b-47/punch-point/README.md

# Punch Point

A low-cost, portable braille embosser.

- [Test rig viewer](https://b-47.github.io/punch-point/concepts/test-rig/viewer/)

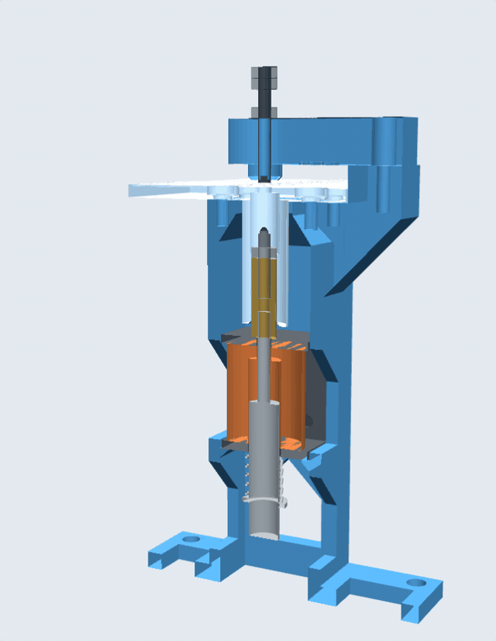
[picture p1: concepts/test-rig/media/strike.gif]
Test rig: the solenoid drives the stylus up through the paper into the die
  

- [Six-solenoid head viewer](https://b-47.github.io/punch-point/concepts/six-solenoid-head/viewer/)

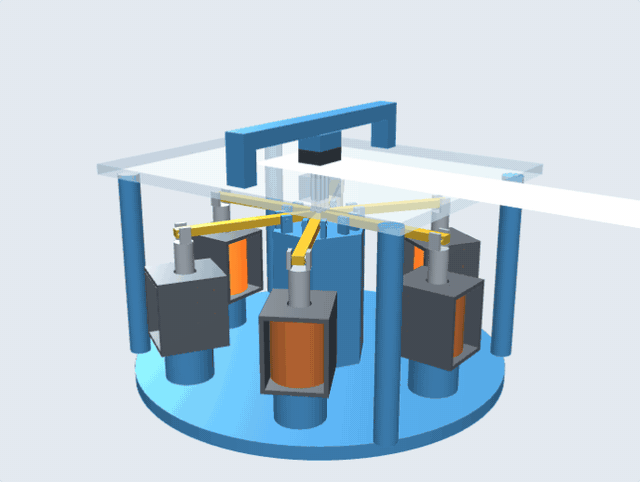
[picture p2: concepts/six-solenoid-head/media/emboss.gif]
Six-solenoid head embossing "punch" one braille cell per strike
  

## License

MIT, see [LICENSE](LICENSE).
