b-47/punch-point/concepts/six_solenoid_head/viewer/index.html

Punch Point · concept sketch, not a tested design

# Six-Solenoid Head

One whole braille cell per strike. Six solenoids stand on a ring and pull six levers. The levers pivot near the middle, so their short inner ends lift six steel pins, set 2.5 mm apart in a 2 × 3 grid, up through the paper into a six-pocket die. Dot-matrix printer heads use the same trick to fit big actuators around a tiny grid of pins.

Lever ratio

3.2 : 1

Pin stroke

3.2 mm

Pin force

≈ 3 × solenoid

Head

≈ 145 mm across

Whole head Pins up close From above Hide table and die

Loading parts…

Word to emboss (letters a–z and spaces)

Emboss Pause

Firing

All of a cell's dots at once One dot after another

p

dots 1 2 3 4

Solenoids on

0

Current now

0 A

Strikes this cell

1

Cells done

0 / 11

Slowed down. Each solenoid draws about 2 A at 12 V while it's on, so firing a whole cell at once needs up to 12 A; one after another never needs more than 2 A but takes a strike per dot.

## What a six-pin head takes

- Six levers and pivots. A solenoid is 22 mm wide and the dots are 2.5 mm apart, so each one reaches its pin through a lever. The 3.2 : 1 ratio turns the 10 mm solenoid stroke into about 3 mm at the pin, at about three times the force, minus pivot friction.
- A six-pocket metal die. Each pin needs its own pocket, lined up within a tenth of a millimetre or so. M3 set screws are 3 mm wide and can't sit 2.5 mm apart, so this is a drilled steel block.
- Power. Up to 12 A when a full cell fires at once, against 2 A for one pin.
- Size and weight. About 145 mm across with six solenoids, all riding on the carriage.
- Parts. The solenoids are cheap (about $3.30 each on the order sheet). The cost is the levers, pivots, pins, die and a bigger supply, plus six channels of the test circuit.

## Speed, and pictures

Rough model for a full page of text (25 lines × 31 cells, about 3 dots a cell). These are estimates, not measurements; the test rig's strike time will firm them up.

Head | Strikes per cell | Page, roughly
One pin | one per dot | ≈ 6 min
Six pins, one after another | one per dot | ≈ 3.5 min
Six pins, all at once | one | ≈ 2 min

Pictures run at one-pin speed whatever the head has: for a tactile graphic the head uses a single pin and moves it anywhere on the page. Six pins only speed up text.
