b-47/punch-point/concepts/six-solenoid-head/cad/iterations/six_head_001_top.png

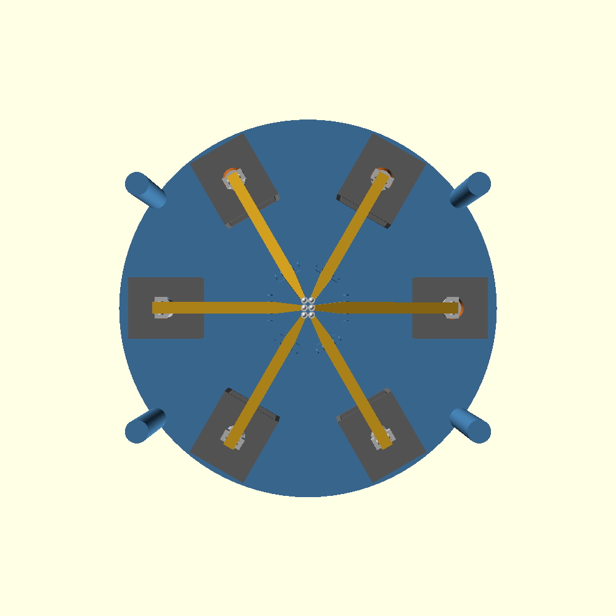
concepts/six-solenoid-head/cad/iterations/six_head_001_top.png
