b-47/punch-point/bom/parts.csv

part | details | unit_cost | qty_one_stylus | qty_six_styli | checked | link
Solenoid | JF-0826B, 12 V, 10 mm stroke | 3.30 | 1 | 6 | 2026-10-16 | https://www.alibaba.com/product-detail/JF-0826B-DC-12V-24V-2A_1600634368825.html
Stylus | M3 x 16 dog-point set screw on an M3 x 18 standoff, with a nut | 1.50 | 1 | 0 | 2026-10-16
Pins and levers | Steel pins and printed levers, one per solenoid | 0.25 | 0 | 6 | 2026-10-16
Die for one stylus | Not designed yet: a die that moves with the stylus, or a fixed grooved bar | 5.00 | 1 | 0 | 2026-10-16
Six-pocket die | A drilled steel block, or the Perkins brailler die if it fits | 10.00 | 0 | 1 | 2026-10-16
Stepper motor | NEMA 17, 42 x 42 x 38 mm: one moves the head, one feeds the paper | 4.72 | 2 | 2 | 2026-10-16 | https://www.omc-stepperonline.com/e-series-nema-17-bipolar-42ncm-59-49oz-in-1-5a-42x42x38mm-4-wires-w-1m-cable-connector-17he15-1504s
Stepper driver | DRV8825 | 2.11 | 2 | 2 | 2026-10-16 | https://www.oyostepper.com/goods-887-5PCSPack-DRV8825-Stepper-Driver-Module-with-Heat-Sink-for-3d-Printer-Reprap.html
Belt | GT2, 6 mm wide, in meters | 1.60 | 0.7 | 0.7 | 2026-10-16
Belt pulley | GT2, 20 teeth | 2.95 | 1 | 1 | 2026-10-16 | https://www.zyltech.com/2gt-gt2-6mm-wide-20t-pulley-5mm-6-35mm-or-8mm-bore/
Idler pulley | GT2, 20 teeth | 3.25 | 1 | 1 | 2026-10-16 | https://www.amazon.com/Double-Idler-Timing-Pulley-Printer/dp/B077MD37XP
Smooth rod | 8 mm across, about 350 mm long | 6.00 | 2 | 2 | 2026-10-16
Linear bearing | LM8UU | 0.67 | 4 | 4 | 2026-10-16
End switch | Finds the head's start position | 1.00 | 1 | 1 | 2026-10-16
Roller shaft | 8 mm across, about 250 mm long | 5.00 | 2 | 2 | 2026-10-16
Rubber ring | O-rings that grip the paper | 0.06 | 8 | 8 | 2026-10-16
Ball bearing | 608 | 0.70 | 4 | 4 | 2026-10-16
Paper sensor | TCRT5000 infrared sensor, finds the paper's edge | 1.20 | 1 | 1 | 2026-10-16
ESP32 board |  | 7.39 | 1 | 1 | 2026-10-16 | https://www.jacobsparts.com/items/DEVBOARD-J
Solenoid driver | MOSFET, diode, 2 resistors and a capacitor, one set per solenoid | 1.50 | 1 | 6 | 2026-10-16
Circuit board and connectors |  | 5.00 | 1 | 1 | 2026-10-16
Wire |  | 3.00 | 1 | 1 | 2026-10-16
Power supply | Sealed 12 V, 5 A wall adapter | 16.00 | 1 | 0 | 2026-10-16
Power supply for six solenoids | Sealed wall adapter; its size depends on how many solenoids fire at once | 28.00 | 0 | 1 | 2026-10-16
PLA filament | Frame, carriage, paper guides and cover, in kg | 12.00 | 0.5 | 0.5 | 2026-10-16
Screws and nuts |  | 5.00 | 1 | 1 | 2026-10-16
