b-47/punch-point/concepts/test-rig/media/v020/3-printed-parts.png

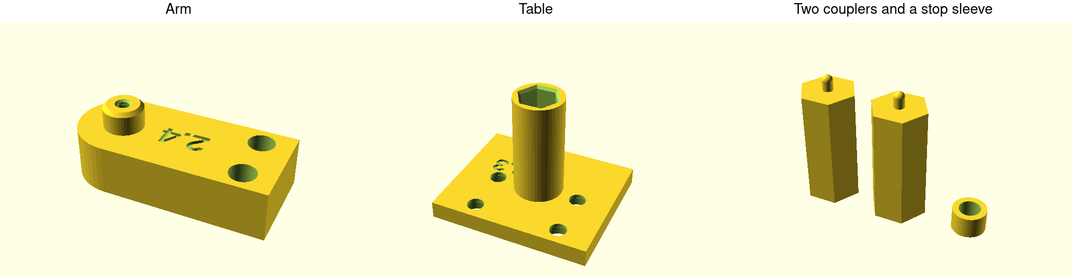
concepts/test-rig/media/v020/3-printed-parts.png
