b-47/punch-point/concepts/test-rig/print/filament_plate_mk4.3mf

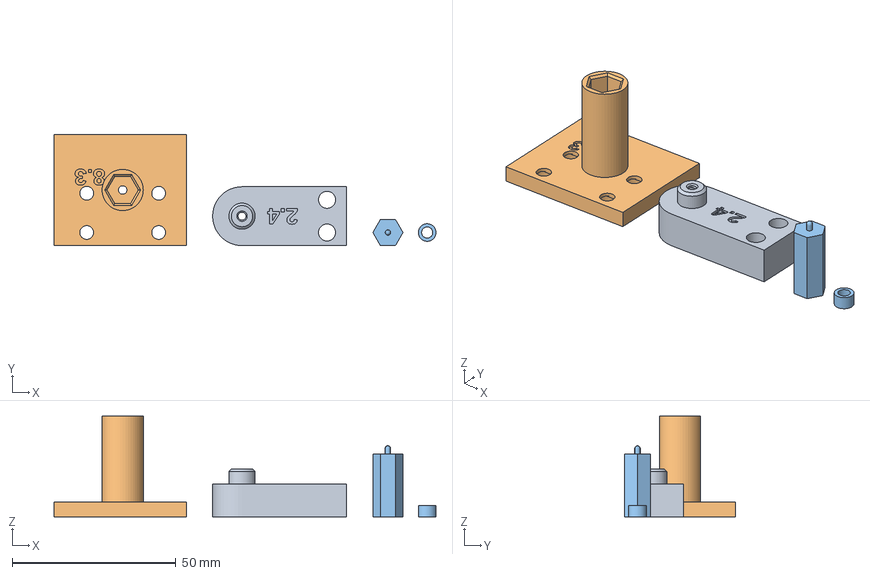
[picture p6: CAD file, 2026-10-30]
concepts/test-rig/print/filament_plate_mk4.3mf
116.8 x 34.0 x 30.8 mm
arm.stl
table_coupler.stl
coupler_parts.stl
