b-47/punch-point/concepts/test-rig/print/coupler_parts.stl

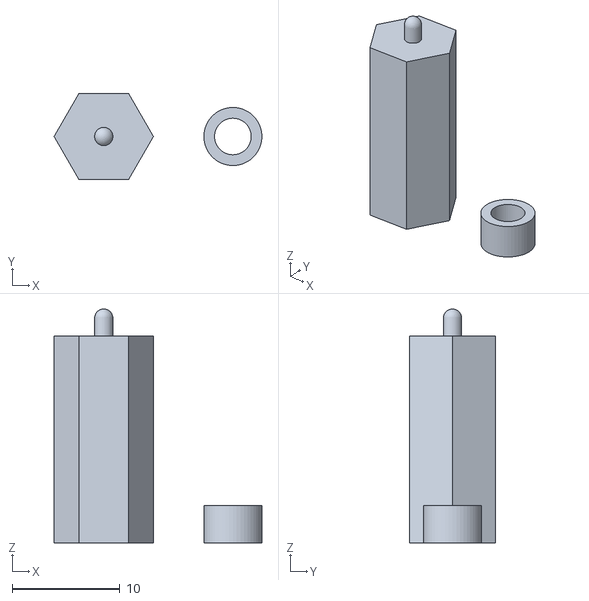
[picture p7: CAD file, 2026-10-30]
concepts/test-rig/print/coupler_parts.stl
19.3 x 8.00 x 21.7
