b-47/punch-point/concepts/test-rig/print/table_coupler.stl

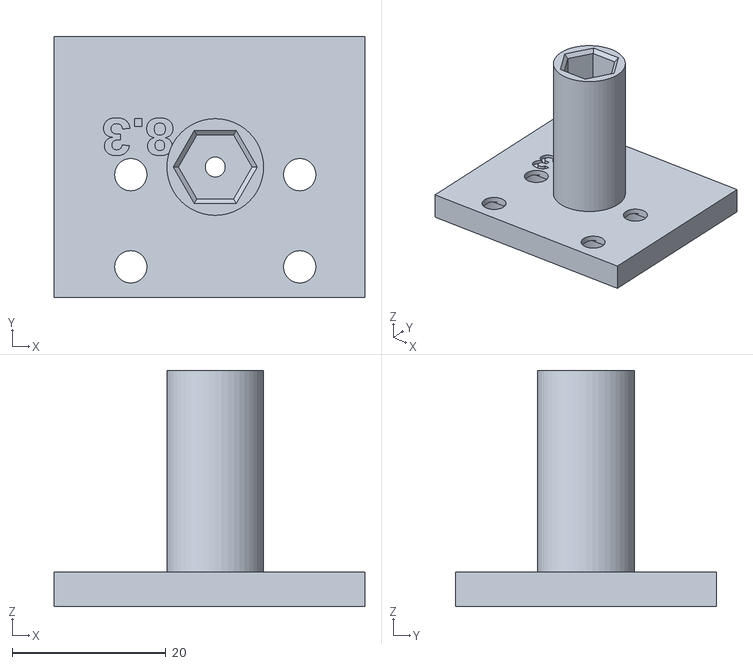
[picture p8: CAD file, 2026-10-30]
concepts/test-rig/print/table_coupler.stl
40.5 x 34.0 x 30.8
