b-47/punch-point/concepts/test-rig/print/arm.stl

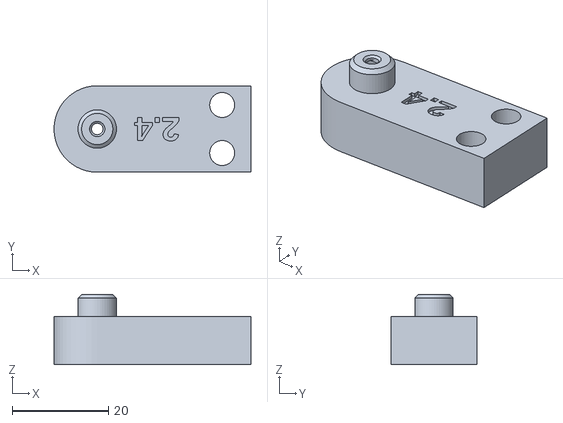
[picture p9: CAD file, 2026-10-30]
concepts/test-rig/print/arm.stl
41.0 x 18.0 x 14.6
