b-47/punch-point/concepts/test-rig/print/rig_plate.3mf

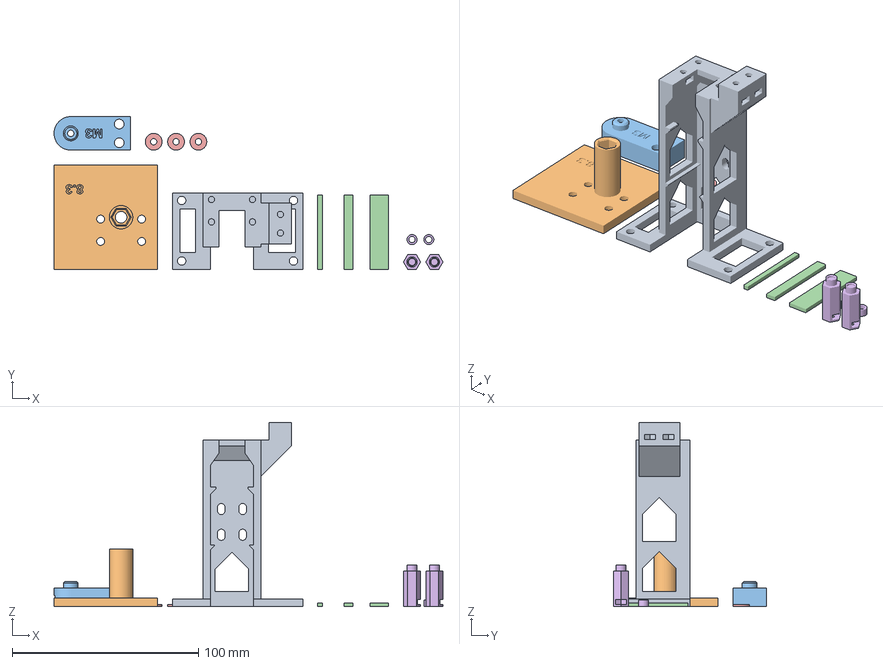
[picture p10: CAD file, 2026-10-23]
concepts/test-rig/print/rig_plate.3mf
208.7 x 82.0 x 98.8 mm
frame.stl
table_coupler.stl
arm_m3.stl
shims.stl
washers.stl
coupler_parts.stl
