b-47/punch-point/concepts/test-rig/print/fix_draft_coreone.3mf

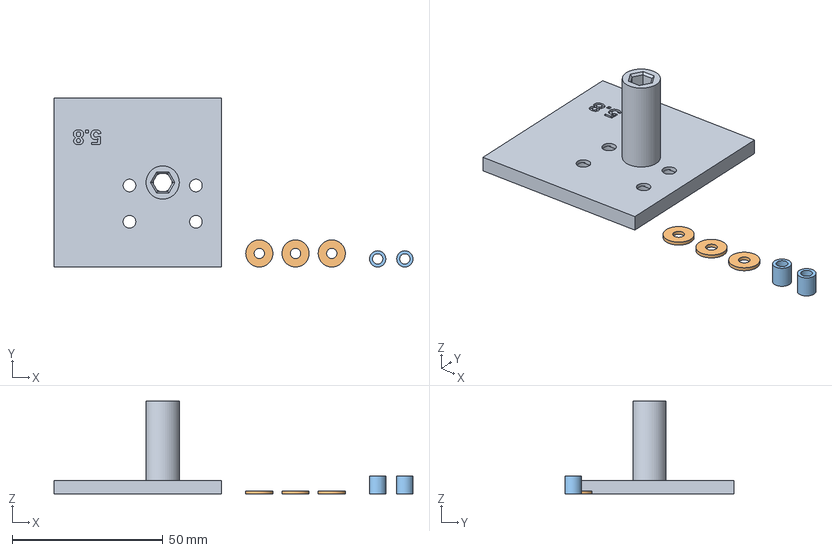
[picture p11: CAD file, 2026-10-21]
concepts/test-rig/print/fix_draft_coreone.3mf
118.9 x 56.0 x 30.8 mm
table_hex5.8.stl
washers.stl
sleeves.stl
