b-47/punch-point/concepts/test-rig/print/sleeves.stl

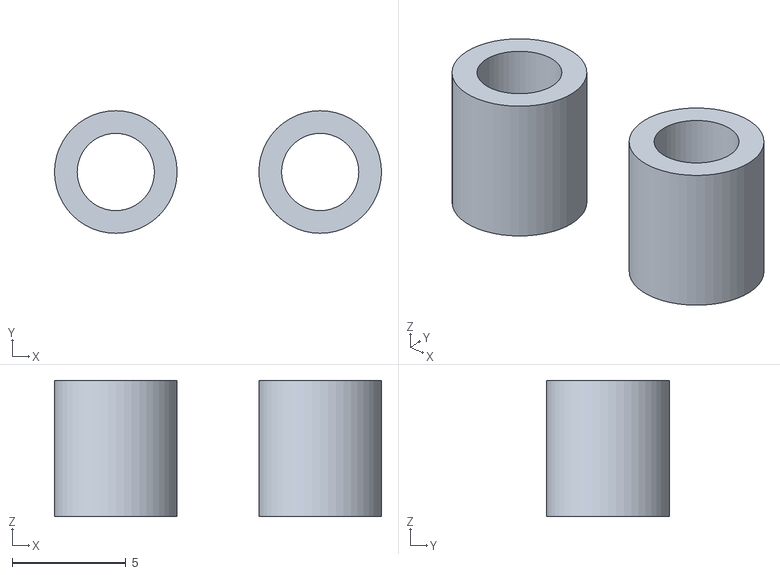
[picture p12: CAD file, 2026-10-21]
concepts/test-rig/print/sleeves.stl
14.4 x 5.40 x 6.00
