b-47/punch-point/concepts/test-rig/print/frame.stl

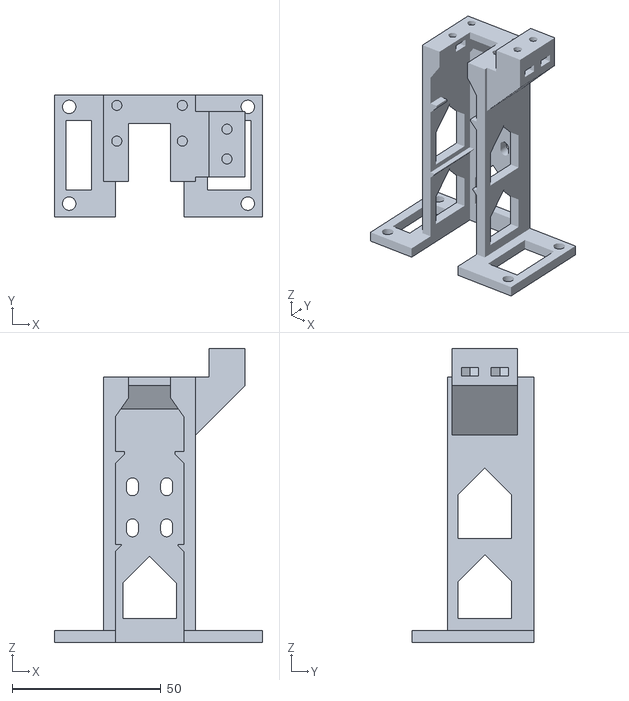
[picture p13: CAD file, 2026-10-21]
concepts/test-rig/print/frame.stl
70.0 x 41.0 x 98.8
