b-47/punch-point/concepts/test-rig/print/shims.stl

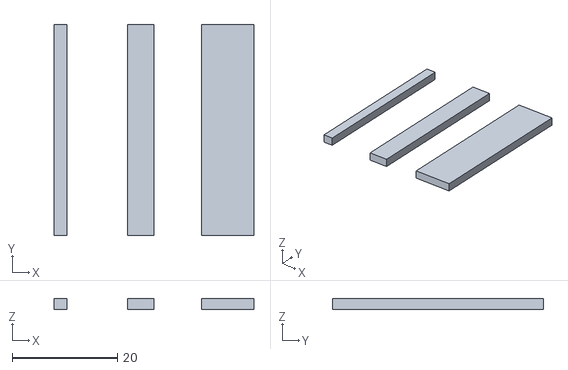
[picture p14: CAD file, 2026-10-19]
concepts/test-rig/print/shims.stl
38.0 x 40.0 x 2.00
