b-47/punch-point/concepts/test-rig/print/washers.stl

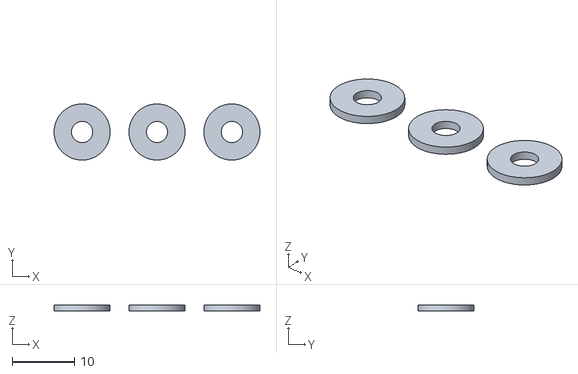
[picture p15: CAD file, 2026-10-21]
concepts/test-rig/print/washers.stl
33.0 x 9.00 x 1.00
