b-47/punch-point/concepts/test-rig/print/arm.scad

// Die arm. The die is the 2.4 mm hole in its nose: the filament stylus pushes the paper up into it. Top face down on the bed.
include <../cad/punch_rig_020.scad>
PART = "arm_print";
