b-47/punch-point/concepts/test-rig/print/coupler_parts.scad

// One printed coupler and a 3.5 mm stop sleeve. The pin on top of a coupler is the stylus.
// Use with the coupler table (table_coupler.scad).
include <../cad/punch_rig_020.scad>
PART = "coupler_parts";
