b-47/punch-point/concepts/test-rig/print/frame.scad

// Frame, printed upright as modelled. PLA, no supports.
include <../cad/punch_rig_020.scad>
PART = "frame_print";
