b-47/punch-point/concepts/test-rig/print/shims.scad

// Fence shims 2.5 / 5 / 10 mm.
include <../cad/punch_rig_020.scad>
PART = "shims";
