b-47/punch-point/concepts/test-rig/print/sleeves.scad

// Stop sleeves (one spare): slide one over the push rod, onto the solenoid. The joining nut lands on it at rest.
include <../cad/punch_rig_020.scad>
PART = "sleeves";
