b-47/punch-point/concepts/test-rig/print/table_coupler.scad

// Table for the printed coupler: an 8.3 mm hex tube for the 8 mm coupler, and a 2.6 mm hole for the filament stylus. Smaller than the
// other tables (40 x 34 mm), to print fast; it still covers the screws and a 30 mm paper strip.
include <../cad/punch_rig_020.scad>
PART = "table_print";
HEX_AF   = 8.3;
NUT_BORE = 9.8;
BOSS_D   = 12.6;
TABLE_X0 = -21;
TABLE_Y  = 17;
