b-47/punch-point/concepts/test-rig/print/washers.scad

// Printed washers for the two arm screws (plus a spare): 9 mm across, 3.4 mm hole, 1 mm thick.
include <../cad/punch_rig_020.scad>
PART = "washers";
