b-47/punch-point/(list of files, cad)

Other CAD files:
concepts/test-rig/print/filament_plate_coreone.3mf
concepts/test-rig/print/rig_plate_mk4.3mf
concepts/six-solenoid-head/cad/iterations/six_head_001.scad
concepts/test-rig/cad/iterations/punch_rig_002.scad
concepts/test-rig/cad/iterations/punch_rig_003.scad
concepts/test-rig/cad/iterations/punch_rig_004.scad
concepts/test-rig/cad/iterations/punch_rig_005.scad
concepts/test-rig/cad/iterations/punch_rig_006.scad
concepts/test-rig/cad/iterations/punch_rig_007.scad
concepts/test-rig/cad/iterations/punch_rig_008.scad
concepts/test-rig/cad/iterations/punch_rig_009.scad
concepts/test-rig/cad/iterations/punch_rig_010.scad
concepts/test-rig/cad/iterations/punch_rig_011.scad
concepts/test-rig/cad/iterations/punch_rig_012.scad
concepts/test-rig/cad/iterations/punch_rig_013.scad
concepts/test-rig/cad/iterations/punch_rig_014.scad
concepts/test-rig/cad/iterations/punch_rig_015.scad
concepts/test-rig/cad/iterations/punch_rig_016.scad
concepts/test-rig/cad/iterations/punch_rig_017.scad
concepts/test-rig/cad/iterations/punch_rig_018.scad
concepts/test-rig/cad/iterations/punch_rig_019.scad
