b-47/punch-point/concepts/test-rig/viewer/index.html

# Punch Test Rig

Cutaway Whole rig Tip close-up

Loading parts…

coil off

Cross-section of the punch point, about 7 mm wide. It shows shapes only. Real paper also stretches and squashes, and testing on the rig shows how much.

Dot height

0.48 mm

Dot base

about 1.50 mm

Paper reaches die

at 9.52 mm

Room at socket edge

0.15 mm

Tight at the socket edge.

Paper thickness0.23 mm

65 lb cover, about 0.23 mm 100 lb cover, about 0.29 mm 160 g/m² paper, about 0.20 mm

Die face above table1.00 mm

Die socket

M3 screw, 1.5 mm socket M4 screw, 2.0 mm socket

Stylus tip radius

0.6 mm 0.75 mm 1.0 mm

Pause

1. 1At restcoil off
2. 2Plunger accelerates0 to 8.75 mm
3. 3Paper lifts to the die8.75 to 9.52 mm
4. 4Dot forms, plunger seats9.52 to 10.00 mm
5. 5Pulse off, plunger fallsthe dot stays
6. 6Paper slides to the next cell6 mm
