b-47/punch-point/concepts/test-rig/cad/iterations/punch_rig_004.png

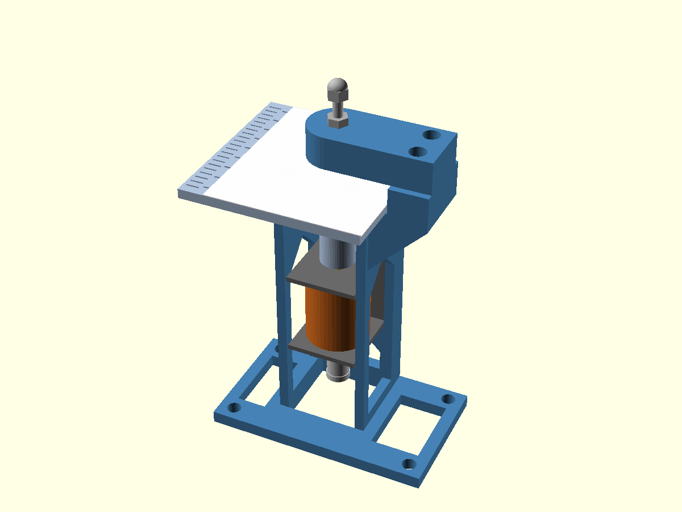
concepts/test-rig/cad/iterations/punch_rig_004.png
