b-47/punch-point/concepts/test-rig/media/circuit.png

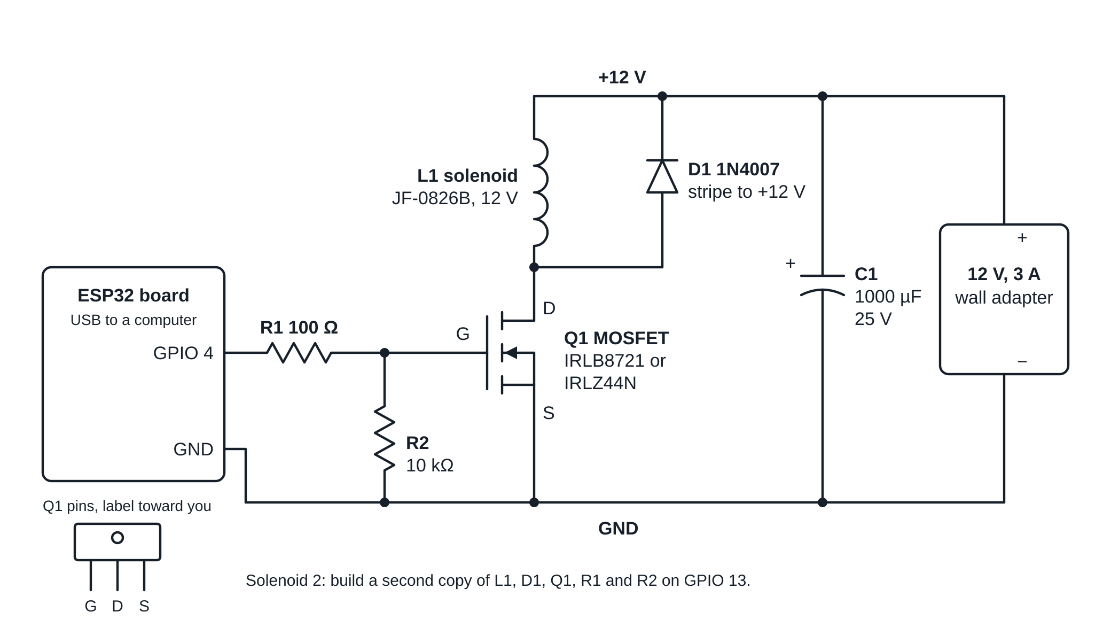
concepts/test-rig/media/circuit.png
