b-47/punch-point/concepts/test-rig/media/v020/1-before-after.png

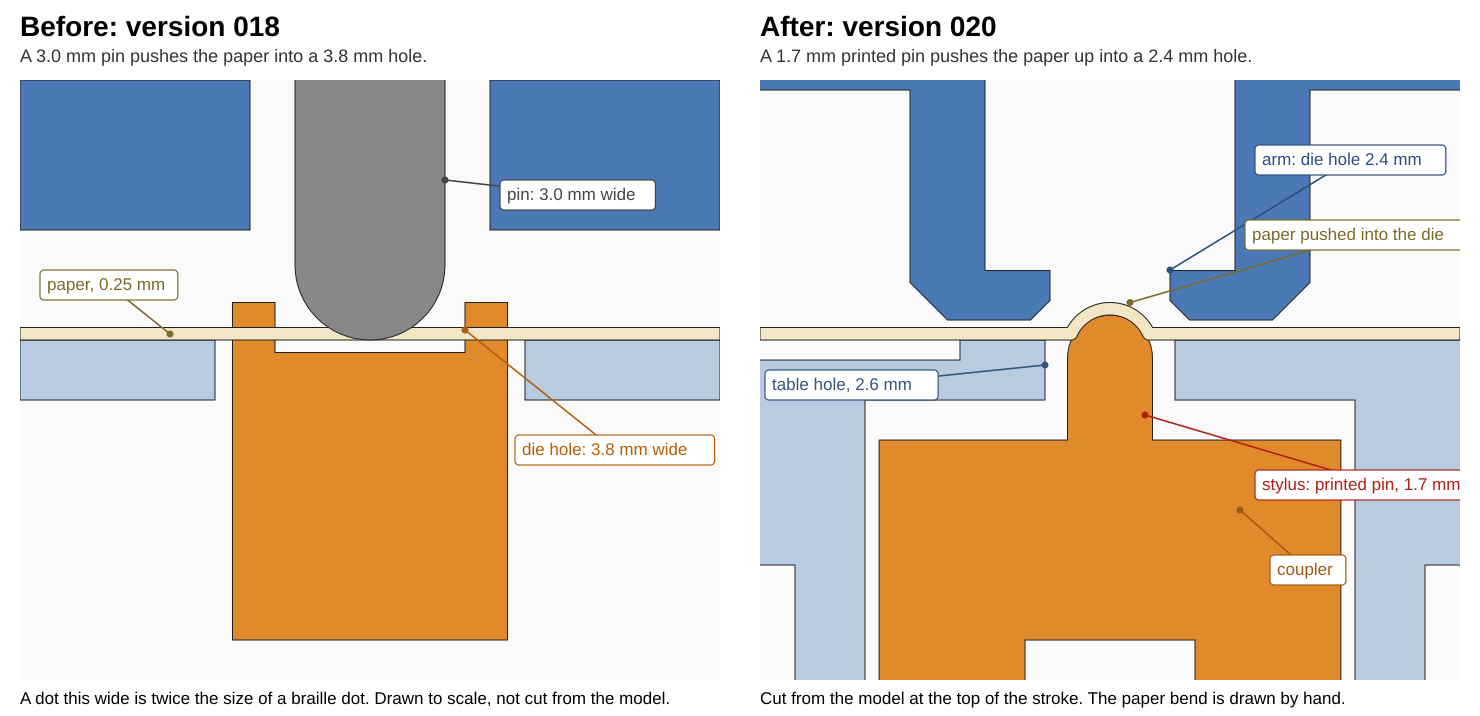
concepts/test-rig/media/v020/1-before-after.png
