b-47/punch-point/concepts/test-rig/media/v020/2-rest-and-fired.png

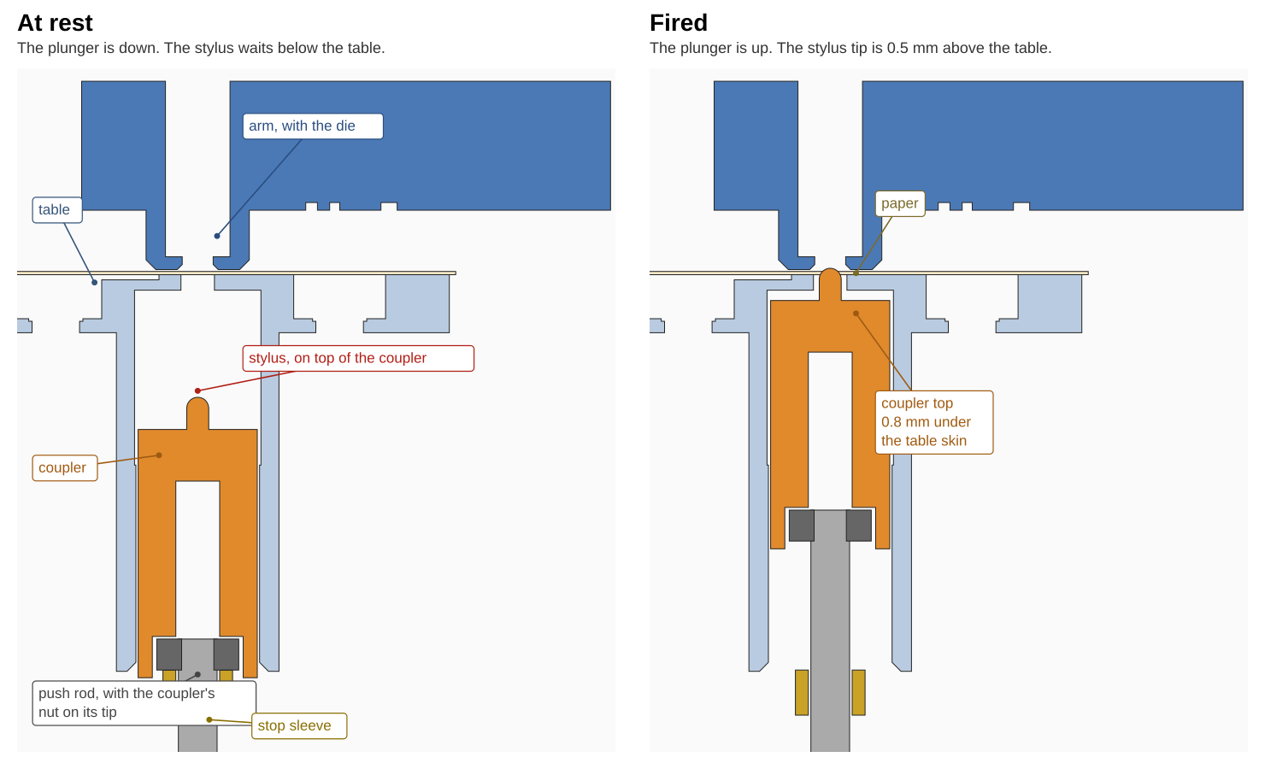
concepts/test-rig/media/v020/2-rest-and-fired.png
