b-47/punch-point/concepts/test-rig/media/v020/4-attachment.png

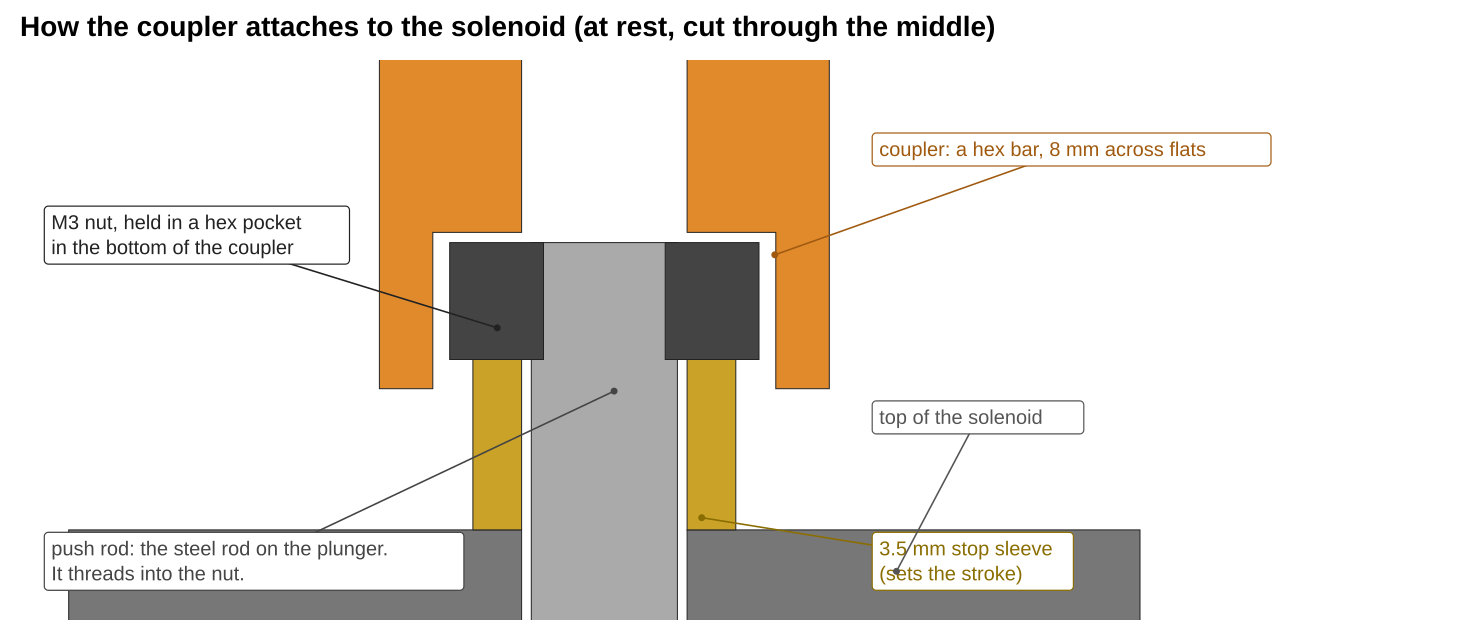
concepts/test-rig/media/v020/4-attachment.png
