b-47/punch-point/(commit log)

2026-10-16 Add test rig v3 and six-solenoid head concept
    Single-dot punch test rig: OpenSCAD model, printable STLs, PrusaSlicer
    project, ESP32 test firmware, and an offline 3D viewer of a strike.
    [arm_m3.scad, arm_m3.stl, arm_m4.scad, arm_m4.stl, frame.scad, frame.stl, punch_rig_v3_001.scad, punch_rig_v3_002.scad]
2026-10-16 Publish viewers on GitHub Pages
    Add a root landing page linking both 3D viewers and link the Pages
    site from the README. Also commits the six-solenoid head v002 concept
    and its viewer, moving v001 into iterations/.
    [six_head_001.scad, six_head_002.scad]
2026-10-16 Test rig v3: half the plastic, solenoid mount that needs no measuring
    v004 keeps the v003 mechanism and trims material: gussets instead of a
    solid wedge under the tower, 3 mm walls with windows, a windowed base,
    a smaller 3 mm table and a shorter arm.
    v005 replaces the screws into the solenoid's unverified M3 holes with a
    slot-in mount: the bottom plate sits on ledges in the side walls, jack
    screws in lips over the top plate hold it down (frame length 25-28 mm),
    zip ties across the front keep it in, and the base is open under the
    plunger with 33 mm of tail room. Checked for 25, 27 and 28 mm bodies:
    no contact through the full stroke, and the solenoid slides in from the
    front with its stylus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
    [arm_m3.scad, arm_m3.stl, arm_m4.scad, arm_m4.stl, coupon.3mf, coupon.scad, coupon.stl, frame.scad]
2026-10-16 Add GIFs of the test rig and six-solenoid head to the README
    tools/record_gifs.py drives each offline viewer frame by frame through
    Chrome DevTools and encodes the GIFs with ffmpeg. The six-solenoid
    viewer gets a small hook so the recorder can step its animation.
2026-10-16 GIFs: show only the 3D parts, and fix the static strike GIF
    The recorder hides the viewer's buttons and status text and captures just
    the 3D canvas. The strike GIF was frozen because each frame redeclared a
    const in the page's global scope and every update after the first threw.
2026-10-16 Rename test-rig-v3 to test-rig so the viewer has one fixed URL
    Drops v3 from the folder, titles and landing page; the landing card now
    shows the strike GIF instead of a render that had moved.
    [arm_m3.scad, arm_m3.stl, arm_m4.scad, arm_m4.stl, coupon.3mf, coupon.scad, coupon.stl, frame.scad]
2026-10-16 Rename the print plate to rig_plate.3mf
    [rig_plate.3mf]
2026-10-16 Move the test rig into concepts/
    [arm_m3.scad, arm_m3.stl, arm_m4.scad, arm_m4.stl, coupon.3mf, coupon.scad, coupon.stl, frame.scad]
2026-10-16 Tidy the repo layout
    - six_solenoid_head -> six-solenoid-head, matching test-rig
    - six-solenoid head CAD moved into cad/ and cad/iterations/, like the test rig
    - punch_rig_v3_NNN -> punch_rig_NNN
    - one shared copy of three.js in vendor/ instead of one per viewer
    - drop the firmware folder's .gitignore; the root one covers it
    [arm_m3.scad, arm_m4.scad, coupon.scad, frame.scad, punch_rig_001.scad, punch_rig_002.scad, punch_rig_003.scad, punch_rig_004.scad]
2026-10-16 Rewrite page and README text in plain language
    Remove the decorative label and repeated spec block from the six-solenoid
    viewer. Replace symbols such as the middle dot, arrows and the approximate
    sign with words. Split long sentences and paragraphs, explain terms the
    first time they appear, and break assembly into one-action steps.
    Also fix the landing page's six-solenoid image, which pointed at a render
    that had moved into cad/.
2026-10-17 Finish the test rig for printing and add its build docs
    Version 006 of the rig model:
    - The deck stops short of the jack screws, so a hex key reaches them
    from above. In 005 they sat under the deck with 12 mm of room, and a
    standard 2.5 mm key needs about 18 mm. The table screws moved to match.
    - The jack screws moved 0.75 mm inward so their heads clear the walls.
    - Solenoid sizes now come from the seller's drawing. The back wall has
    slots for the solenoid's own M3 holes.
    - A stroke spacer sets the stroke again, because the standoff replaces
    the acorn nut that used to stop the plunger at rest.
    - The table skin is 1.2 mm, giving the stylus lock nut more room.
    - Each table has its hex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
    [arm_m3.scad, arm_m3.stl, arm_m4.scad, arm_m4.stl, coupon.3mf, coupon.scad, coupon.stl, frame.scad]
2026-10-17 Add a public parts and costs page
    bom/parts.csv lists every part with its price and where the price came
    from. bom/index.html reads it and totals the cost per build and the cost
    to buy everything, for the test rig and both embosser designs, against
    the $200 goal. The README links to it.
    [parts.csv]
2026-10-17 Keep the embossed dot after the stylus falls in the rig viewer
    The paper used to follow the stylus back down, so the dot vanished. A
    real dot is permanent: the paper keeps the depth it was pressed to and
    lands on the table with the dot raised. After each strike the strip now
    slides one cell, 6 mm, along the fence, past a row of earlier dots.
2026-10-17 Remove the landing page
    The README links to the viewers and the parts page directly, so the site doesn't need a front page. The parts page loses its link back to it.
2026-10-17 Print the three fence shims as separate pieces
    The shims overlapped in the model, so they printed fused into one stepped piece. They now sit side by side. The plate is rebuilt.
    [punch_rig_006.scad, rig_plate.3mf, shims.stl]
2026-10-17 Print the first test rig in PLA
    PLA bridges cleanly and strings less for the first print. The plate and coupon are re-sliced for Prusament PLA, and the docs and parts list match. PLA softens at about 55 °C, so the heat test now stops at 50 °C.
    [coupon.3mf, coupon.scad, frame.scad, parts.csv, punch_rig_006.scad, rig_plate.3mf]
2026-10-17 Hold the solenoid with two screws into its own holes (version 007)
    The seller's drawing gives the solenoid's size and its two threaded M3
    holes, so the adjustable mount is no longer needed. Two M3 x 6 screws
    through slots in the back wall now hold the solenoid. The jack screws,
    the zip ties and their slots, the gap in the deck and the fit coupon
    are gone. Small fixed lips over the top plate stop the solenoid jumping
    if the screws are out.
    The plate is re-sliced in PLA, and the viewer, build pictures, docs and
    parts list match. The viewer now skips a part missing from an older
    cached parts file instead of failing to load.
    [arm_m3.scad, arm_m4.scad, coupon.3mf, coupon.scad, coupon.stl, frame.scad, frame.stl, parts.csv]
2026-10-17 Count the test rig's cost without the reused test gear
    The $61 per rig counted the ESP32, breadboard, power adapter and switch parts, which we reuse between tests, plus a single-standoff price and Prusament filament. Test electronics now count only toward the cost to buy everything, filament is $12 per kg, and the standoff uses a 10-pack price. The rig comes to about $7 in parts.
    [parts.csv]
2026-10-17 Make the BOM a plain bill of materials for the embosser
    The test rig is our own bench tool, not part of the product, so it is out of the BOM. The page is now one table: each part with its unit cost and its quantity in the one-stylus and six-styli designs, with a total for each.
    [parts.csv]
2026-10-17 Drop the glue and thread locker from the test rig
    A plain nut and the acorn nut, tightened against each other on top of the die screw, now turn it both ways, so nothing needs gluing. The standoff needs no thread locker, because the table's hex guide stops it turning. The guide, test plan, notes, log sheet, model and viewer match.
    [punch_rig_007.scad, test-log.csv]
2026-10-17 Re-render the 007 preview with the locked die nuts
2026-10-17 Use plain nuts instead of the acorn nut on the die screw
    Two plain M3 nuts locked together turn the die screw, so the acorn nut is no longer needed. The guide, test plan, model, viewer, pictures and animation match.
    [punch_rig_007.scad]
2026-10-17 Trim descriptions from the READMEs and the BOM page
    Links stand on their own, without a line describing each one.
2026-10-17 Specify an M4 x 30 set screw for the M4 die
    Three M4 nuts on an M4 x 25 leave only about 1.4 mm to lower the die.
2026-10-17 Fix the die screw step and add the paper strip width
    The die set screw's only socket is on its bottom end, so it goes into the arm from below on a hex key. A strip about 30 mm wide keeps the table's tick marks in view.
2026-10-17 Cut the README to a short description and the two viewers
2026-10-17 Make every test rig part pass a layer-by-layer print check (version 008)
    tools/print_check.py slices each part in print orientation and fails on
    material over thin air, bridges that end in mid-air and slivers thinner
    than one line, as pc-case's build check does. It found two faults:
    - The deck beside the boss slot hung up to 6.7 mm over the solenoid
    pocket. Slopes under the deck along both side walls now carry it,
    and the slot's back end is square so the deck behind it bridges.
    - The table's counterbores print facing the bed, so the layer above
    each one hung 1.8 mm over its screw hole. Each now has a stepped
    bridge, and the screw holes are 4.2 mm.
    The plate is re-sliced with 4 perim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
    [arm_m3.scad, arm_m4.scad, frame.scad, frame.stl, punch_rig_007.scad, punch_rig_008.scad, rig_plate.3mf, shims.scad]
2026-10-18 Remove the frame's long bridges and turn the brim on (version 009)
    PrusaSlicer warned of long bridges in the frame and low bed adhesion on
    the shims:
    - The platform under the tower bridged 16 mm between two gussets, and
    PrusaSlicer flags PLA bridges past 16 mm. One gusset now runs its
    full width.
    - A slope under the deck behind the boss slot means no part of the
    deck bridges.
    - Earlier plates set a 5 mm brim width but left brim_type at the
    preset's no_brim, so no brim printed. It is now outer_only.
    tools/print_check.py now limits bridges to 12 mm and reads the plate's
    G-code: it fails without 4/5/5/25% walls or a brim that really prints.
    [arm_m3.scad, arm_m4.scad, frame.scad, frame.stl, punch_rig_008.scad, punch_rig_009.scad, rig_plate.3mf, shims.scad]
2026-10-18 Make the viewers' view buttons land on their view
    After a drag, the camera kept the drag's leftover spin, so clicking Whole rig or another view landed on the view and then drifted off it. The view buttons now spend that spin before placing the camera.
2026-10-19 Hold the die arm with captive nuts in the tower (version 010)
    The arm screws cut their own thread in the PLA tower, which wears out each time the arm comes off to swap dies. Two M3 nuts now slide into slots in the tower's outer face, and M3 x 20 screws pass through them. Each slot's ceiling is a stepped bridge around the screw hole.
    [arm_m3.scad, arm_m4.scad, frame.scad, frame.stl, punch_rig_009.scad, punch_rig_010.scad, rig_plate.3mf, shims.scad]
2026-10-19 Hold the die and the table with captive nuts too (version 011)
    No screw cuts its own thread in the PLA now. The die screw threads through an M3 nut in a slot in the arm's round end, and the table screws (now M3 x 8) go into four M3 nuts in slots under the deck, open to the front and back faces. The side walls are 4 mm so the slots stay enclosed.
    [arm_m3.scad, arm_m3.stl, arm_m4.scad, arm_m4.stl, frame.scad, frame.stl, punch_rig_010.scad, punch_rig_011.scad]
2026-10-19 Sink socket head table screws below the paper and print on Balanced (version 012)
    The table is 4.5 mm thick, with 3.2 mm counterbores for M3 socket heads, and the deck sits 1.5 mm lower to match. The plate now prints with 3 perimeters, 4 top and 4 bottom layers, 15% gyroid and a 5 mm brim on the Balanced profile: about 3 hours instead of 4.
    [arm_m3.scad, arm_m4.scad, frame.scad, frame.stl, punch_rig_011.scad, punch_rig_012.scad, rig_plate.3mf, shims.scad]
2026-10-19 Shorten the front table nut slots to clear PrusaSlicer's floating bridge anchors (version 013)
    The front table nuts slid in through 14 mm slots from the front face. PrusaSlicer turns its bridge lines over the open slot there and warns of floating bridge anchors. Those nuts now slide in from the boss slot through 5 mm slots, like every other nut slot.
    [arm_m3.scad, arm_m4.scad, frame.scad, frame.stl, punch_rig_012.scad, punch_rig_013.scad, rig_plate.3mf, shims.scad]
2026-10-19 Add the test rig plate sliced for a Prusa MK4
    Same parts and settings as the Core One plate: Prusament PLA, 3 perimeters, 4 top and 4 bottom layers, 15% gyroid, 5 mm brim. The MK4 has no Balanced profile at 0.20 mm with a 0.4 nozzle, so it uses Speed, whose speeds match Balanced. The print check now audits every plate's G-code.
    [rig_plate_mk4.3mf]
2026-10-21 Match the back-wall slots to the measured solenoid holes (version 014)
    Calipers on the real solenoid: holes 13.8 mm apart along and 11.5 mm across (the drawing says 14.5 and 12), the nearer one 7.3 mm from the push-rod end, and a 26.6 mm frame. The slots now centre on those holes. Only the frame changes.
    [arm_m3.scad, arm_m4.scad, frame.scad, frame.stl, punch_rig_013.scad, punch_rig_014.scad, rig_plate.3mf, rig_plate_mk4.3mf]
2026-10-21 Publish the build guide as a web page, and add firing by hand
    build-guide.html is generated from build-guide.md by tools/build_guide_page.py, since the site serves Markdown unrendered. The guide now sets the stylus to 7.4 mm for our 26.6 mm solenoids, makes rounding the stylus optional, and has a step for firing the first dot by hand from a 12 V supply without the electronics.
2026-10-21 Build the die and pin from plain M3 screws and nuts (version 015)
    No standoff, set screws or steel washers. The die is an M3 x 16 socket head screw riding head-up on the push rod, joined by a nut, with a stop nut setting the stroke; its 2.5 mm hex socket shapes the dot. The pin is an M3 x 20 screw pointing down through the arm's captive nut, tip sanded round. The table's top hole grows to 6.2 mm for the screw head, and two printed washers cover the arm's oversize screw holes. Only the table changes: rig_plate_fix prints it with the washers in about 41 minutes.
    [arm_m3.scad, arm_m4.scad, frame.scad, punch_rig_014.scad, punch_rig_015.scad, rig_plate.3mf, rig_plate_fix.3mf, rig_plate_fix_mk4.3mf]
2026-10-21 Picture every build step and trim the build guide's opening
    tools/build_guide_images.py renders the step pictures from the current model, with the part being added in orange. The guide now has one for the pin, the stroke spacer, the die screw, the table nuts, sliding the solenoid in, the back screws, the table, the arm and the finished rig. The opening and the print section are shorter.
2026-10-21 Set the stroke with a printed stop sleeve instead of a stop nut (version 016)
    Our solenoids' push rods are threaded only about 4 mm from the tip, so a stop nut can't sit low enough, and the raised ring on top of the solenoid keeps the stroke spacer from lying flat. A printed sleeve over the smooth part of the rod now stops the joining nut at rest. The stroke is about 8 mm; the strike height is unchanged. The stroke spacer is removed and the sleeves print on the fix plate.
    [arm_m3.scad, arm_m4.scad, frame.scad, punch_rig_015.scad, punch_rig_016.scad, rig_plate.3mf, rig_plate_fix.3mf, rig_plate_fix_mk4.3mf]
2026-10-21 Give the printed arm washers their own step and show them in the arm picture
    [fix_draft_coreone.3mf]
2026-10-22 Add a printed die cap with a hole wide enough for the pin (version 017)
    The first test struck the paper but only marked it: the 3 mm pin couldn't push paper into a screw head's 2.5 mm socket. A printed cap with a 3.8 mm die hole now sits on an M3 x 10 by a hex peg, its top where the M3 x 16's head was. The guide now describes the nut flush on the push rod's tip, with the screw and cap dropped in through the table.
    [arm_m3.scad, arm_m4.scad, die_caps.scad, die_caps.stl, die_caps_coreone.3mf, die_caps_mk4.3mf, frame.scad, punch_rig_016.scad]
2026-10-23 Join the die to the push rod with a printed coupler (version 018)
    The dropped-in die screw had play, so the die could wander under the pin. A printed coupler now screws onto the push rod by a captive M3 nut; its 8 mm hex body rides in the coupler table's 8.3 mm tube, and the top of its neck is the 3.8 mm die. A 3.5 mm stop sleeve gives about 9 mm of stroke. coupler_plate prints the table, two couplers and two sleeves; the full plates now hold only current parts.
    [arm_m3.scad, arm_m4.scad, coupler_parts.scad, coupler_parts.stl, coupler_plate_coreone.3mf, coupler_plate_mk4.3mf, die_caps.scad, die_caps_coreone.3mf]
2026-10-23 Set the pin height against the paper, for the coupler's wider die
    With the 3.8 mm die hole the pin tip drops into the hole, so lowering it onto the die and raising one turn set it too deep. Touch the paper with the plunger up, then go one turn further.
2026-10-23 Center the arm before laying paper, then set the pin height against the paper
2026-10-30 Press the paper up into a 2.4 mm die with a printed 1.7 mm stylus (version 020)
    The 3 mm screw pin in a 3.8 mm hole made dots twice the size of braille dots. The stylus is now a 1.7 mm domed pin printed on top of the coupler. The die is a 2.4 mm hole in the arm's nose. Dots face up. The rig needs no M4 screw, standoff or pin screw.
    The coupler's nut pocket is open at the bottom and 0.6 mm over the nut, so the coupler hangs on the nut. The model now places the coupler by that roof, which puts the tip 0.5 mm above the table at full stroke. The table's stylus hole is 2.6 mm.
    One plate holds the arm, the coupler table, one coupler and one stop sleeve. It is sliced with 2 perimeters for the Pru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
    [arm.scad, arm.stl, arm_m3.scad, arm_m3.stl, arm_m4.scad, arm_m4.stl, coupler_parts.scad, coupler_parts.stl]
